maks7d/fcg4/README.md

This project aims to develop an ultra minimalist flight controller for betaflight firmware for FPV drones.
The components are : 
- STM32G473CEU6 (mcu)
- SPL006 (barometer)
- ICM-42688-P (gyro/accel)
No analog OSD and no BlackBox
