maks7d/fcg4/.step

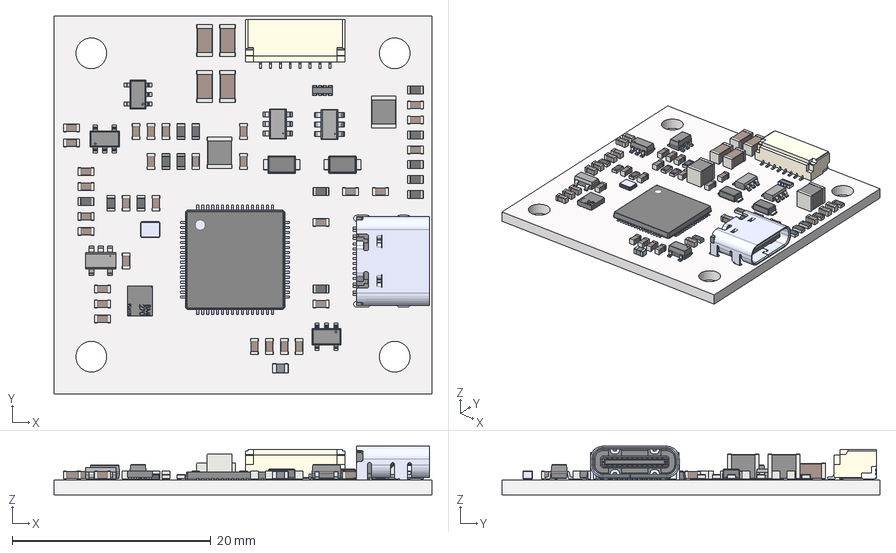
[picture p1: CAD file, 2026-05-31]
.step
38.0 x 38.0 x 4.91 mm
R_0603_1608Metric x 14
PinsArrayL x 3
PinsArrayR x 3
C_0603_1608Metric x 30
C_1206_3216Metric x 4
AP2112K-1_8TRG1_DIO
EXB-28V101JX
STM32G473RCT6
SM08B-SRSS-TB
MP2456GJ-Z x 2
L_1210_3225Metric x 2
BMI270
CPD x 2
Lead x 2
Lead_2 x 2
Outer plating_2 x 2
Outer plating x 2
BLM18RK601SN1D
USB4105xxx_USB4105GFA120
ECS-240-6-37B-7KM-TR
fcg4_PCB
