maks7d/fcg4/3D/BMI270.stp

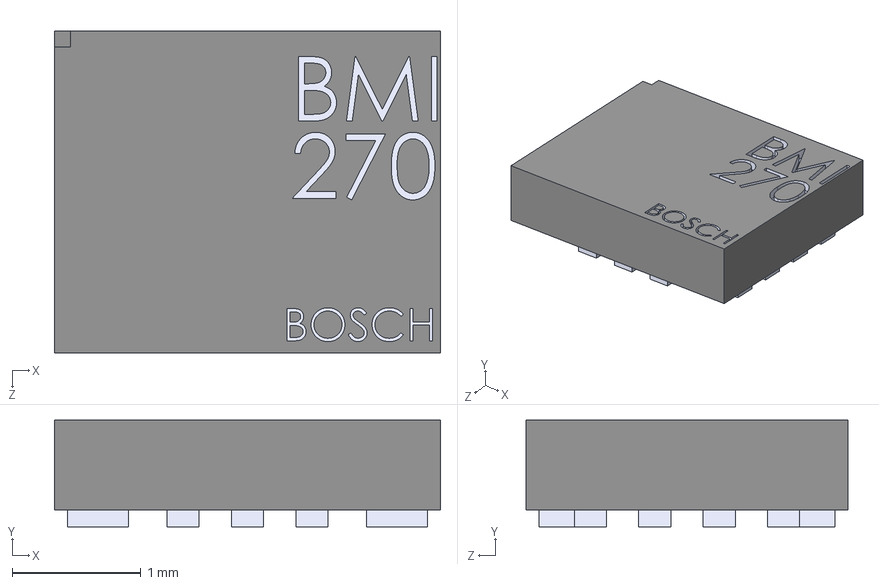
[picture p2: CAD file, 2026-04-12]
3D/BMI270.stp
3.00 x 0.83 x 2.50 mm
