maks7d/fcg4/3D/STM32G473RCT6.stp

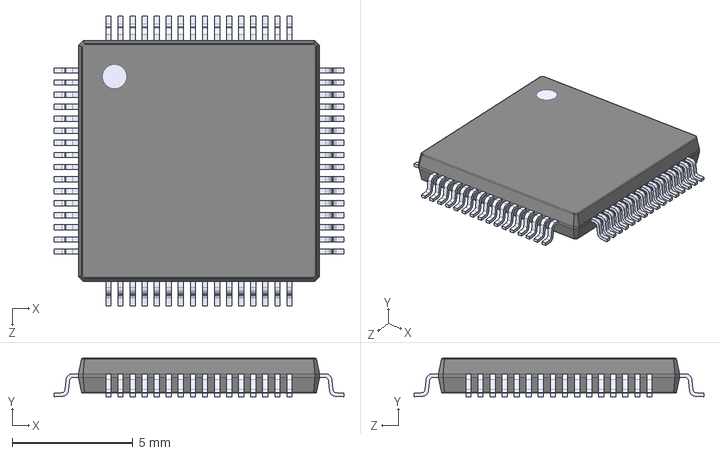
[picture p3: CAD file, 2026-03-20]
3D/STM32G473RCT6.stp
12.0 x 1.60 x 12.0 mm
