maks7d/fcg4/Stencil_jig_template.stl

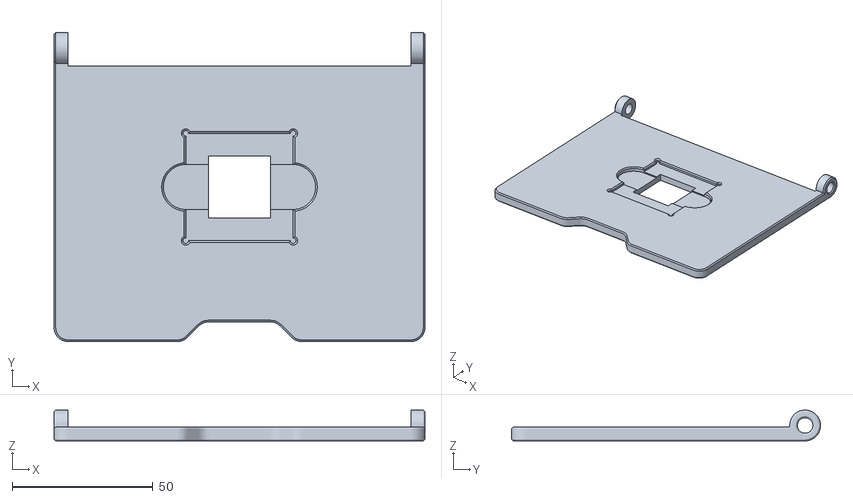
[picture p4: CAD file, 2026-05-31]
Stencil_jig_template.stl
132.0 x 110.0 x 11.0
