maks7d/fcg4/3D/STM32G473CET6.stp

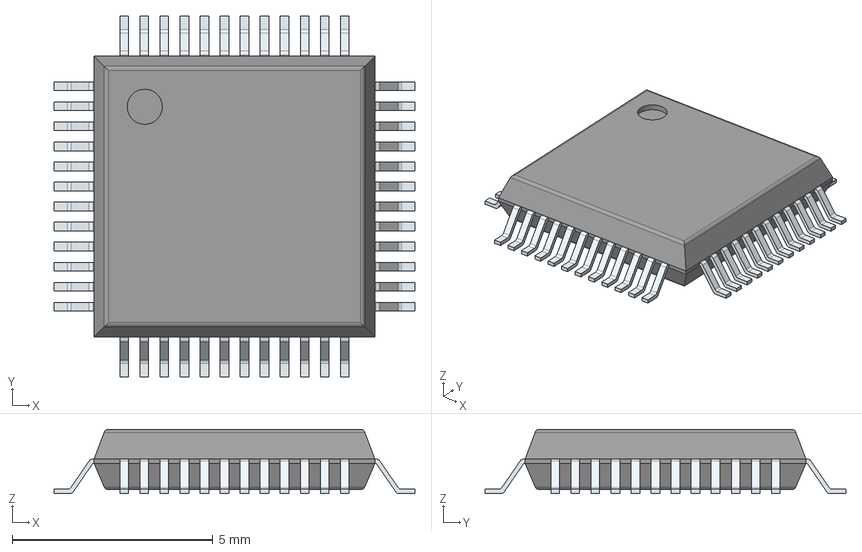
[picture p5: CAD file, 2026-03-20]
3D/STM32G473CET6.stp
9.00 x 9.00 x 1.60 mm
PinsArrayLR
PinsArrayTB
