maks7d/fcg4/3D/MP2456GJ-Z.stp

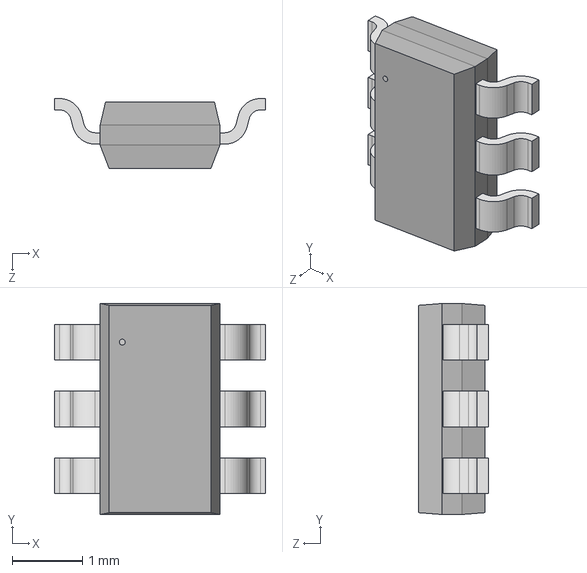
[picture p6: CAD file, 2026-02-27]
3D/MP2456GJ-Z.stp
3.00 x 3.00 x 0.993 mm
