maks7d/fcg4/3D/DFLS160-7.stp

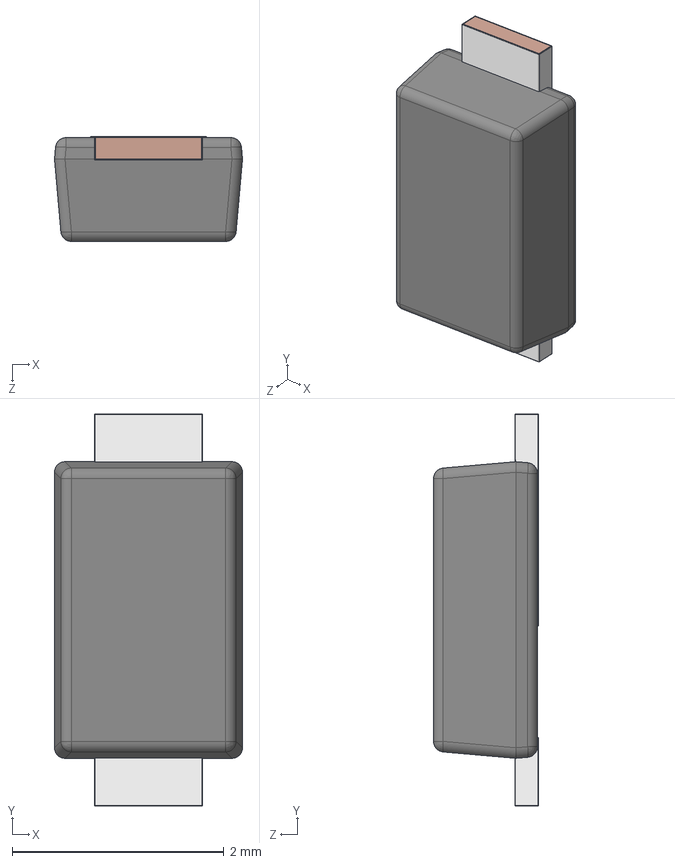
[picture p7: CAD file, 2026-02-27]
3D/DFLS160-7.stp
1.77 x 3.70 x 0.99 mm
CPD
Lead
Lead_2
Outer plating_2
Outer plating
