maks7d/fcg4/3D/STM32G473CEU6.stp

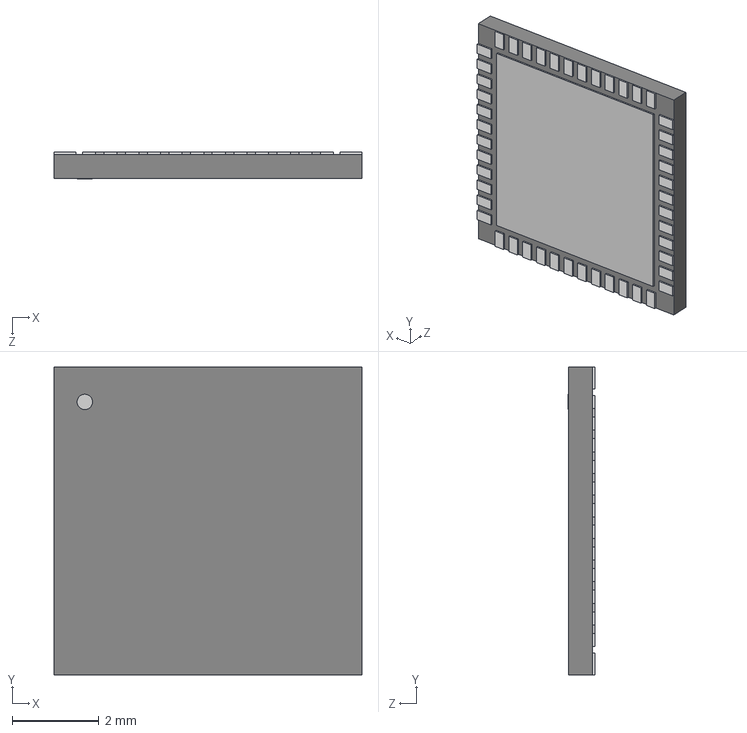
[picture p8: CAD file, 2026-02-18]
3D/STM32G473CEU6.stp
7.11 x 7.11 x 0.612 mm
