maks7d/fcg4/3D/AP2112K-3.3TRG1.stp

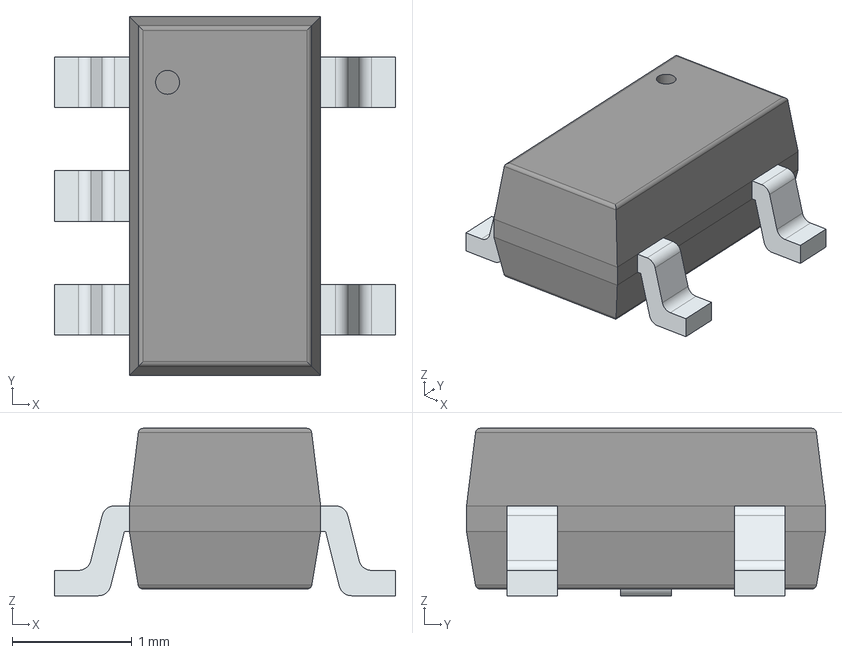
[picture p9: CAD file, 2026-02-18]
3D/AP2112K-3.3TRG1.stp
2.85 x 3.00 x 1.40 mm
PinsArrayL
PinsArrayR
