maks7d/fcg4/3D/EXB-28V101JX.STEP

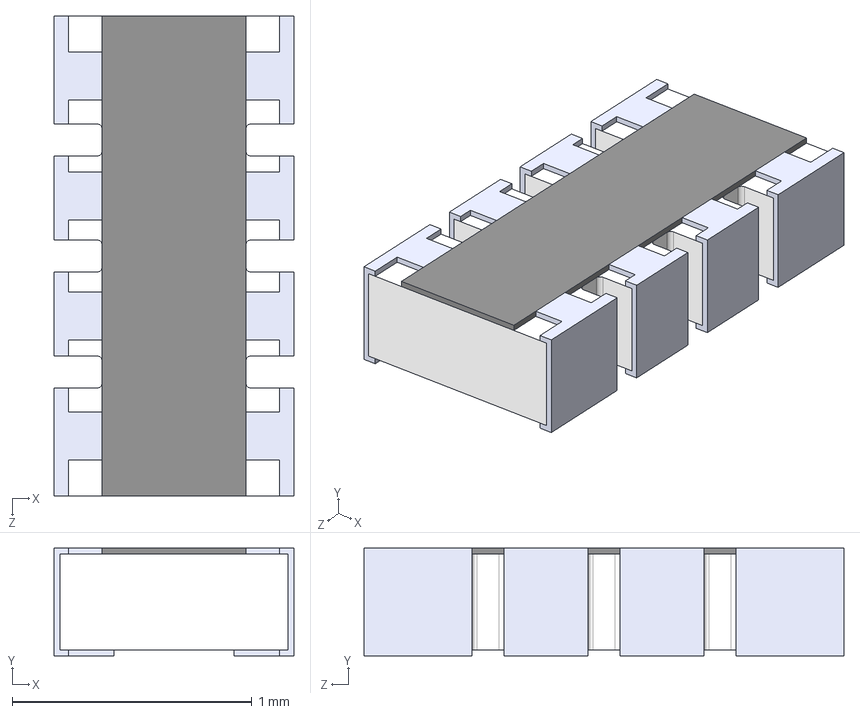
[picture p10: CAD file, 2026-02-18]
3D/EXB-28V101JX.STEP
1.00 x 0.45 x 2.00 mm
