maks7d/fcg4/3D/SM08B-SRSS-TB.step

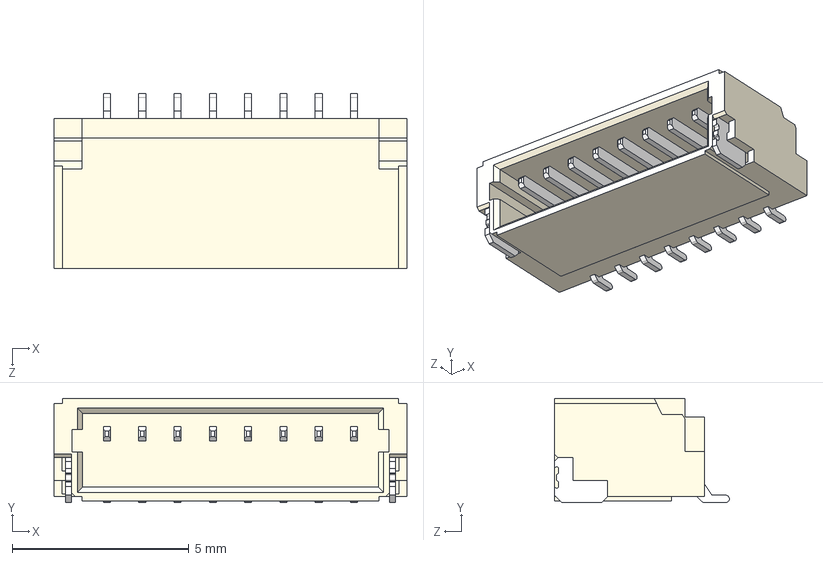
[picture p11: CAD file, 2026-02-15]
3D/SM08B-SRSS-TB.step
10.00 x 2.95 x 4.95 mm
