maks7d/fcg4/3D/ECS-240-6-37B-7KM-TR.step

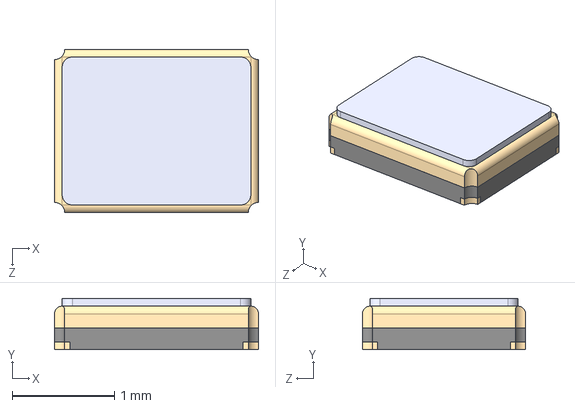
[picture p12: CAD file, 2026-02-15]
3D/ECS-240-6-37B-7KM-TR.step
2.00 x 0.5 x 1.60 mm
