maks7d/fcg4/3D/CX2016DB25000D0GPSC1.stp

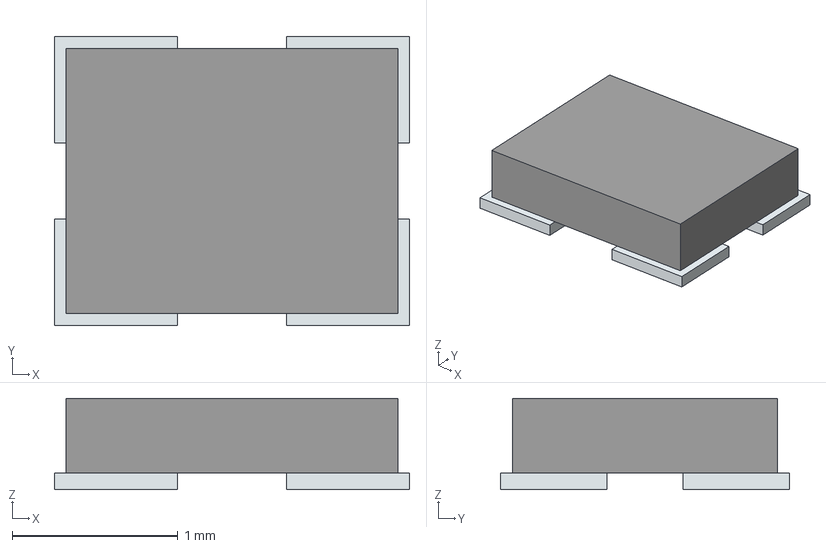
[picture p13: CAD file, 2026-02-14]
3D/CX2016DB25000D0GPSC1.stp
2.14 x 1.74 x 0.55 mm
Pins
