maks7d/fcg4/3D/BLM18RK601SN1D.step

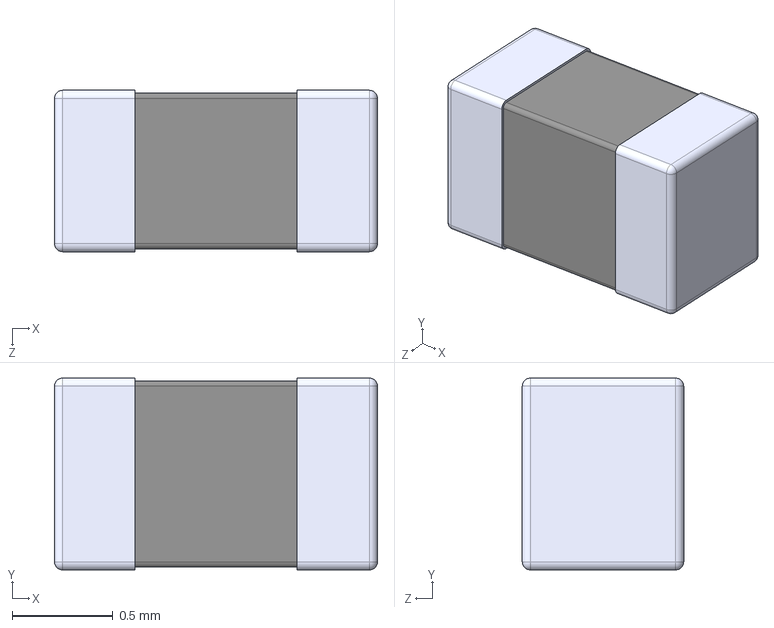
[picture p14: CAD file, 2026-02-14]
3D/BLM18RK601SN1D.step
1.60 x 0.95 x 0.8 mm
