maks7d/fcg4/3D/USB4105-GF-A-120.step

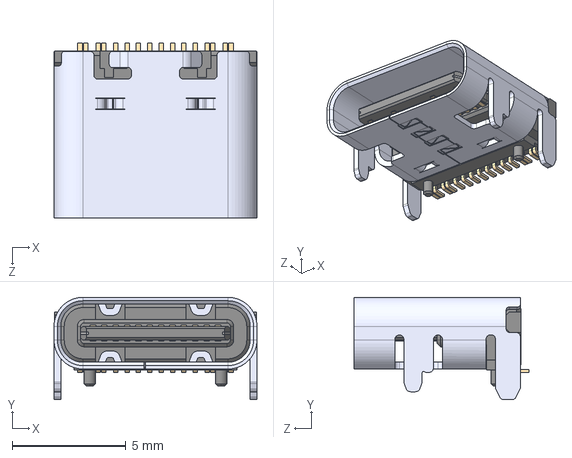
[picture p15: CAD file, 2026-02-13]
3D/USB4105-GF-A-120.step
8.94 x 4.51 x 7.71 mm
