maks7d/fcg4/3D/ABM3C-25.000MHZ-D4Y-T.STEP

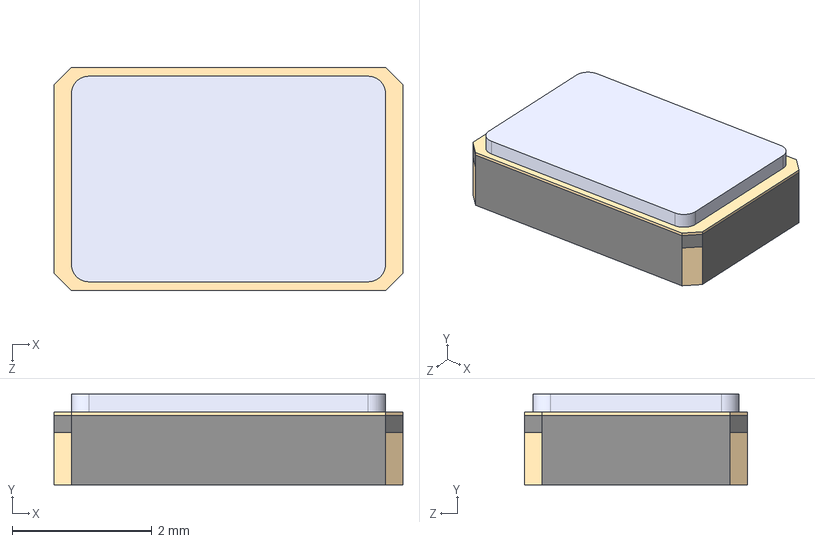
[picture p16: CAD file, 2026-02-13]
3D/ABM3C-25.000MHZ-D4Y-T.STEP
5.00 x 1.30 x 3.20 mm
