maks7d/fcg4/3D/SM04B-SRSS-TB.STEP

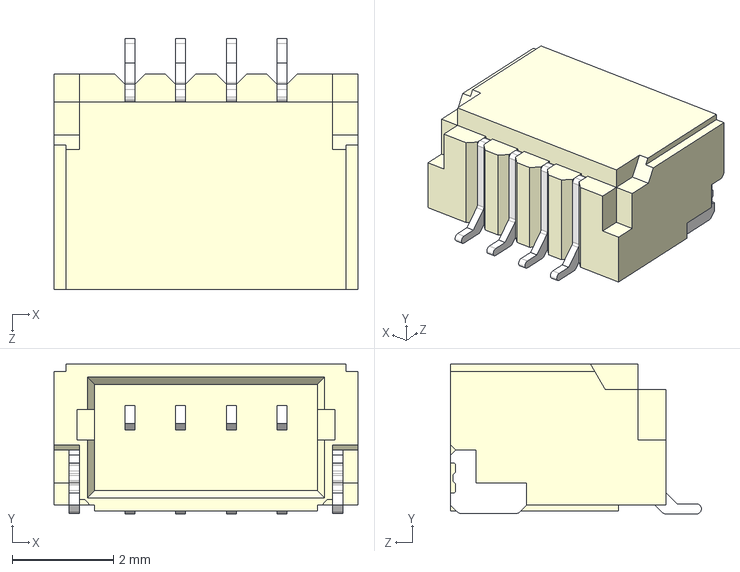
[picture p17: CAD file, 2026-02-12]
3D/SM04B-SRSS-TB.STEP
6.00 x 2.96 x 4.95 mm
