maks7d/fcg4/3D/1N5819HW-7-F.stp

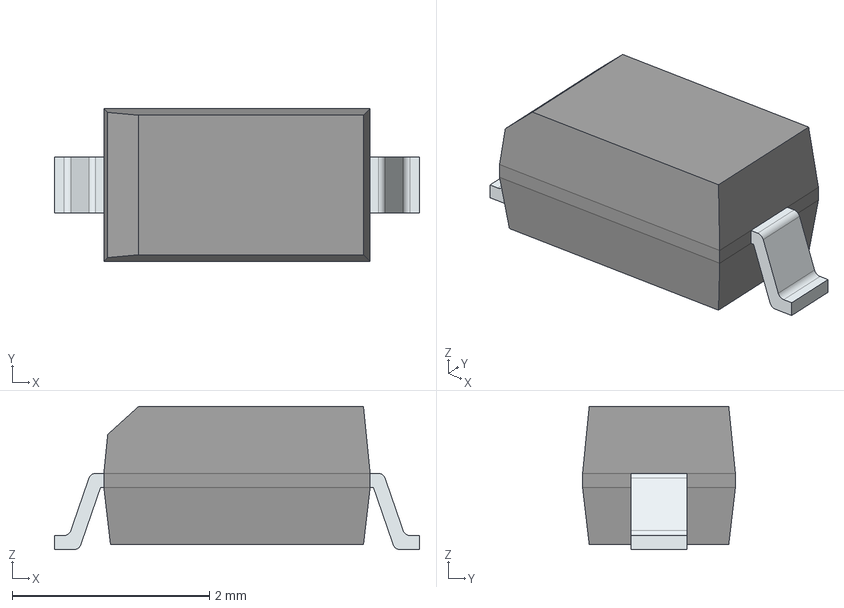
[picture p18: CAD file, 2026-02-12]
3D/1N5819HW-7-F.stp
3.70 x 1.55 x 1.45 mm
FilletPinL
FilletPinR
