maks7d/fcg4/3D/AP2112K-1_8TRG1_DIO.step

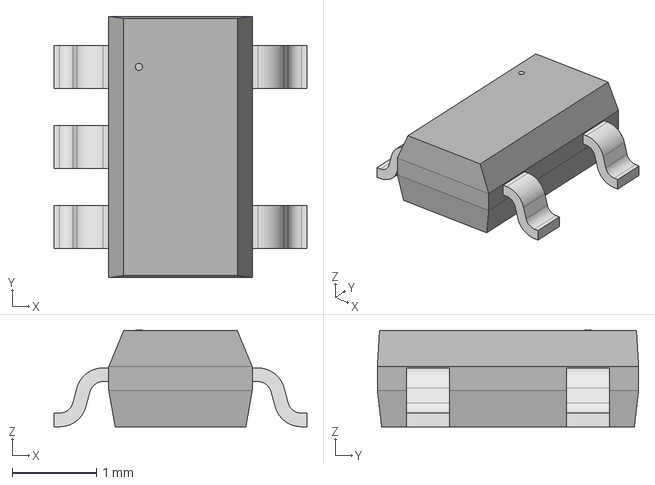
[picture p19: CAD file, 2026-02-12]
3D/AP2112K-1_8TRG1_DIO.step
3.00 x 3.10 x 1.15 mm
