maks7d/fcg4/3D/Goertek SPL06-001.stp

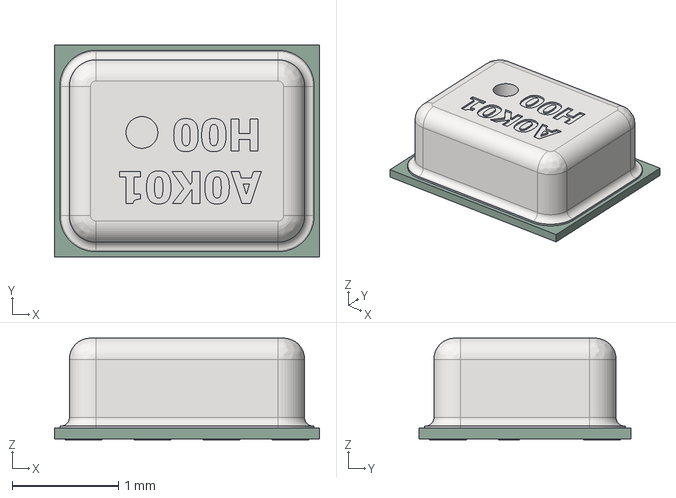
[picture p20: CAD file, 2026-02-12]
3D/Goertek SPL06-001.stp
2.50 x 2.00 x 0.96 mm
