maks7d/fcg4/3D/MP9943AGQ-Z.stp

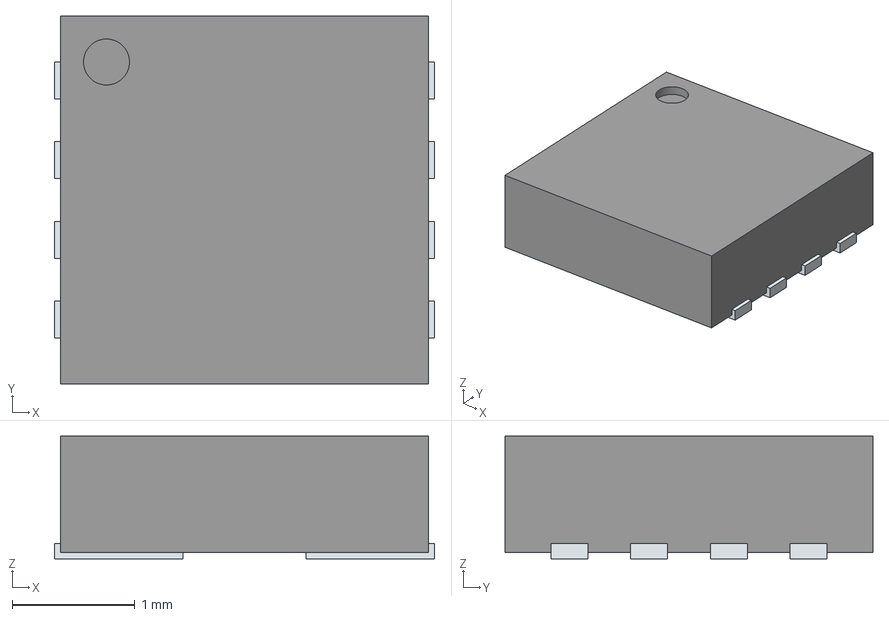
[picture p21: CAD file, 2026-02-12]
3D/MP9943AGQ-Z.stp
3.10 x 3.00 x 1.00 mm
PinsArrayLR
