maks7d/fcg4/3D/ICM-42688-P.step

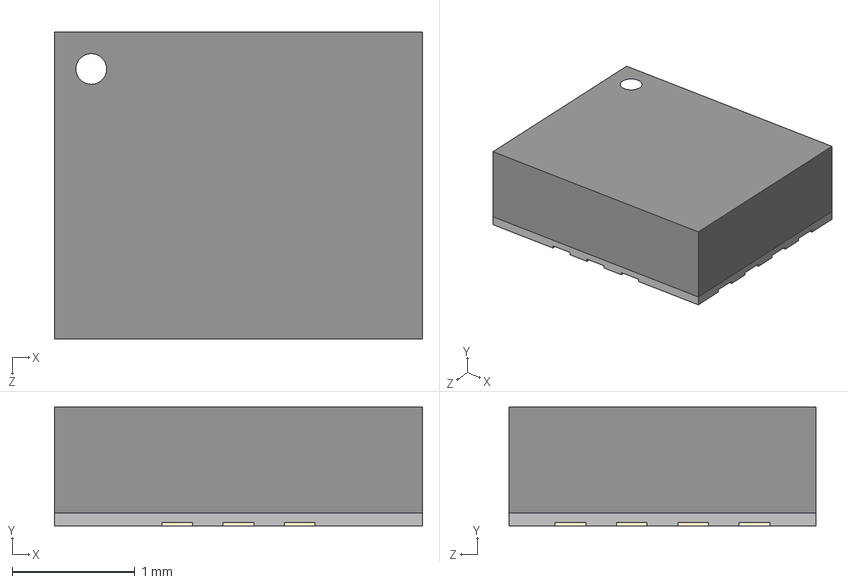
[picture p22: CAD file, 2026-02-11]
3D/ICM-42688-P.step
3.00 x 0.97 x 2.50 mm
