maks7d/fcg4/(list of files, cad)

Other CAD files:
3D/2171750001.step
3D/MAX40200ANS_T.step
3D/MAX40203AUK+T.stp
