maks7d/fcg4/fcg4.kicad_pcb

## KiCad design fcg4.kicad_pcb (2026-05-31)

Schematic: fcg4.kicad_sch

Parts:
H1: MountingHole; MountingHoles_30.5x30.5mm_Standard

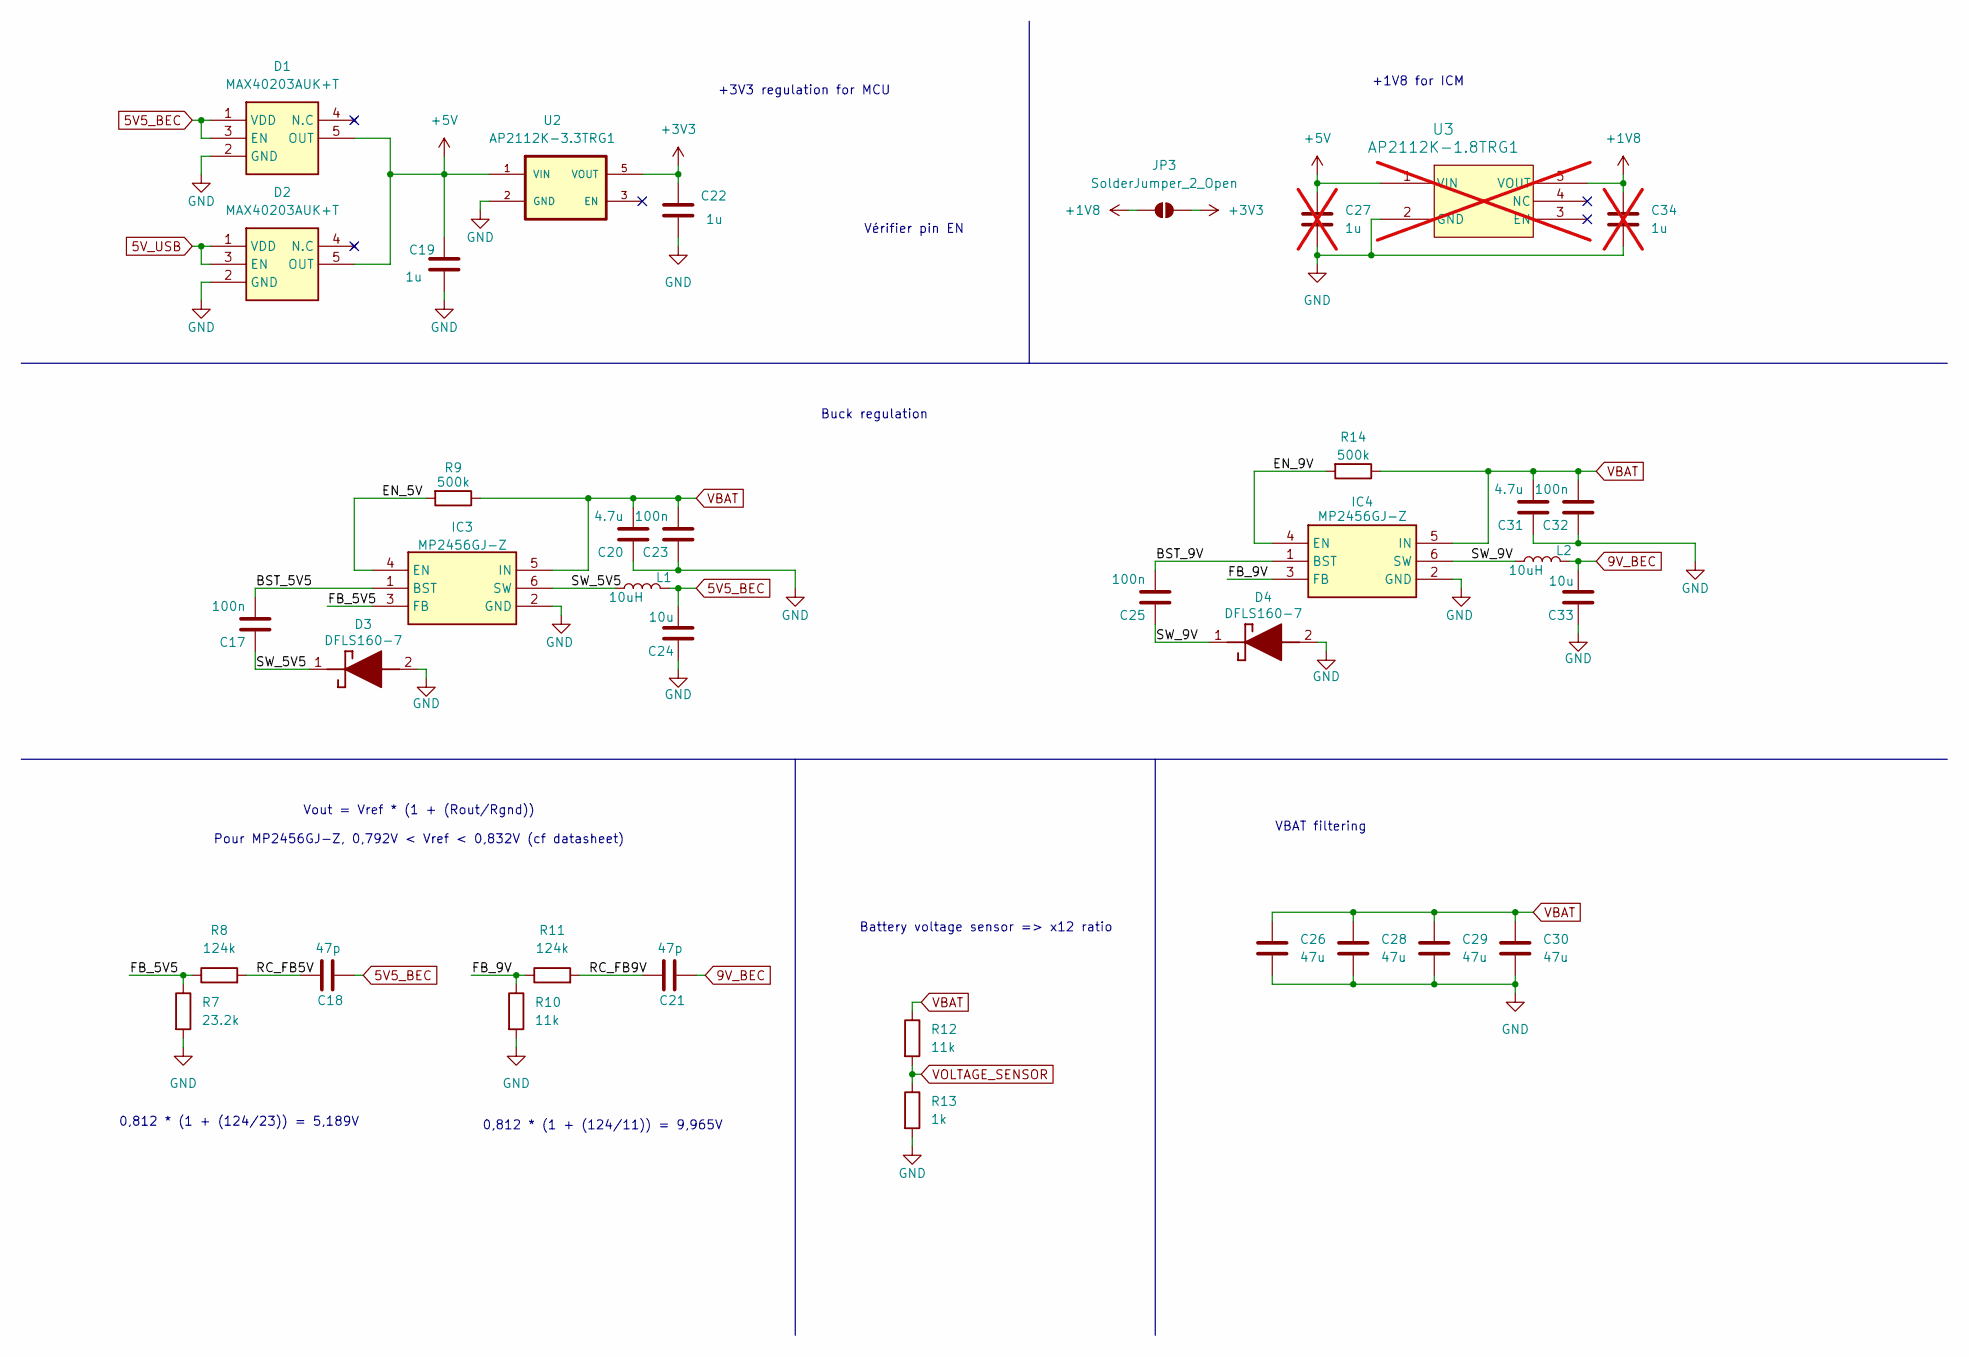
[picture p23: schematic power.kicad_sch]

Parts:
C17, C23, C25, C32: 100n; C_0603_1608Metric; Manufacturer_Part_Number CL10B104KB8NNNC; LCSC Part Name C1591
C18, C21: 47p; C_0603_1608Metric; Manufacturer_Part_Number CC0603JRNPO9BN470; LCSC Part Name C105622
C19, C22: 1u; C_0603_1608Metric; Manufacturer_Part_Number CL10B105KB8NQNC; LCSC Part Name C5199872
C20, C31: 4.7u; C_0603_1608Metric; Manufacturer_Part_Number CL10A475KL8NRNC; LCSC Part Name C307467
C24, C33: 10u; C_0603_1608Metric; Manufacturer_Part_Number GRM188R6YA106MA73D; LCSC Part Name C194427
C26, C28, C29, C30: 47u; C_1206_3216Metric; Manufacturer_Part_Number C3216X5R1E476MTJ00E; LCSC Part Name C76659
C27, C34: 1u; C_0603_1608Metric; Manufacturer_Part_Number CL10B105KB8NQNC; LCSC Part Name C5199872; not fitted
D1, D2: MAX40203AUK+T; SOT95P280X145-5M; Mouser Part Number 700-MAX40203AUK+T
D3, D4: DFLS160-7; DFLS1607; Mouser Part Number 621-DFLS160-F
IC3, IC4: MP2456GJ-Z; SOP95P280X100-6M; Mouser Part Number 946-MP2456GJ-Z
JP3: SolderJumper_2_Open; SolderJumper-2_P1.3mm_Open_TrianglePad1.0x1.5mm
L1, L2: 10uH; L_1210_3225Metric; Manufacturer_Part_Number XRTC322512S100MBCA; LCSC Part Name C39846661
R7: 23.2k; R_0603_1608Metric; Manufacturer_Part_Number RT0603BRE0723K2L; LCSC Part Name C861768
R8, R11: 124k; R_0603_1608Metric; Manufacturer_Part_Number 0603WAF1243T5E; LCSC Part Name C22788
R9, R14: 500k; R_0603_1608Metric; Manufacturer_Part_Number 0603WAF4993T5E; LCSC Part Name C26751
R10, R12: 11k; R_0603_1608Metric; Manufacturer_Part_Number 0603WAF1102T5E; LCSC Part Name C25950
R13: 1k; R_0603_1608Metric; Manufacturer_Part_Number RC0603FR-071KL; LCSC Part Name C22548
U2: AP2112K-3.3TRG1; SOT95P285X140-5N; PARTREV 2-2; DigiKey_Part_Number AP2112K-3.3TRG1DICT-ND
U3: AP2112K-1.8TRG1; AP2112K-1.8TRG1_DIO; Manufacturer_Part_Number AP2112K-1.8TRG1; Mouser Part Number 621-AP2112K-1.8TRG1; not fitted

Connections:
5V5_BEC: C18.1, C24.2, D1.1 (VDD), D1.3 (EN), L1.2; also elsewhere on the board
5V_USB: D2.1 (VDD), D2.3 (EN); also elsewhere on the board
9V_BEC: C21.1, C33.2, L2.2; also elsewhere on the board
+1V8: C34.1, JP3.1 (A), U3.5 (VOUT); also elsewhere on the board
+3V3: C22.1, JP3.2 (B), U2.5 (VOUT); also elsewhere on the board
+5V: C19.1, C27.1, D1.5 (OUT), D2.5 (OUT), U2.1 (VIN), U3.1 (VIN); also elsewhere on the board
/Power/BST_5V5: C17.2, IC3.1 (BST)
/Power/BST_9V: C25.2, IC4.1 (BST)
/Power/EN_5V: IC3.4 (EN), R9.2
/Power/EN_9V: IC4.4 (EN), R14.2
/Power/FB_5V5: IC3.3 (FB), R7.1, R8.1
/Power/FB_9V: IC4.3 (FB), R10.1, R11.1
/Power/RC_FB5V: C18.2, R8.2
/Power/RC_FB9V: C21.2, R11.2
/Power/SW_5V5: C17.1, D3.1 (K), IC3.6 (SW), L1.1
/Power/SW_9V: C25.1, D4.1 (K), IC4.6 (SW), L2.1
GND: C19.2, C20.1, C22.2, C23.1, C24.1, C26.2, C27.2, C28.2, C29.2, C30.2, C31.1, C32.1, C33.1, C34.2, D1.2 (GND), D2.2 (GND), D3.2 (A), D4.2 (A), IC3.2 (GND), IC4.2 (GND), R7.2, R10.2, R13.2, U2.2 (GND), U3.2 (GND); also elsewhere on the board
VBAT: C20.2, C23.2, C26.1, C28.1, C29.1, C30.1, C31.2, C32.2, IC3.5 (IN), IC4.5 (IN), R9.1, R12.1, R14.1; also elsewhere on the board
VOLTAGE_SENSOR: R12.2, R13.1; also elsewhere on the board

Notes on the sheet:
+3V3 regulation for MCU
Vérifier pin EN
Vout = Vref * (1 + (Rout/Rgnd)) Pour MP2456GJ-Z, 0,792V < Vref < 0,832V (cf datasheet)
0,812 * (1 + (124/23)) = 5,189V
Battery voltage sensor => x12 ratio
+1V8 for ICM
0,812 * (1 + (124/11)) = 9,965V
VBAT filtering
Buck regulation

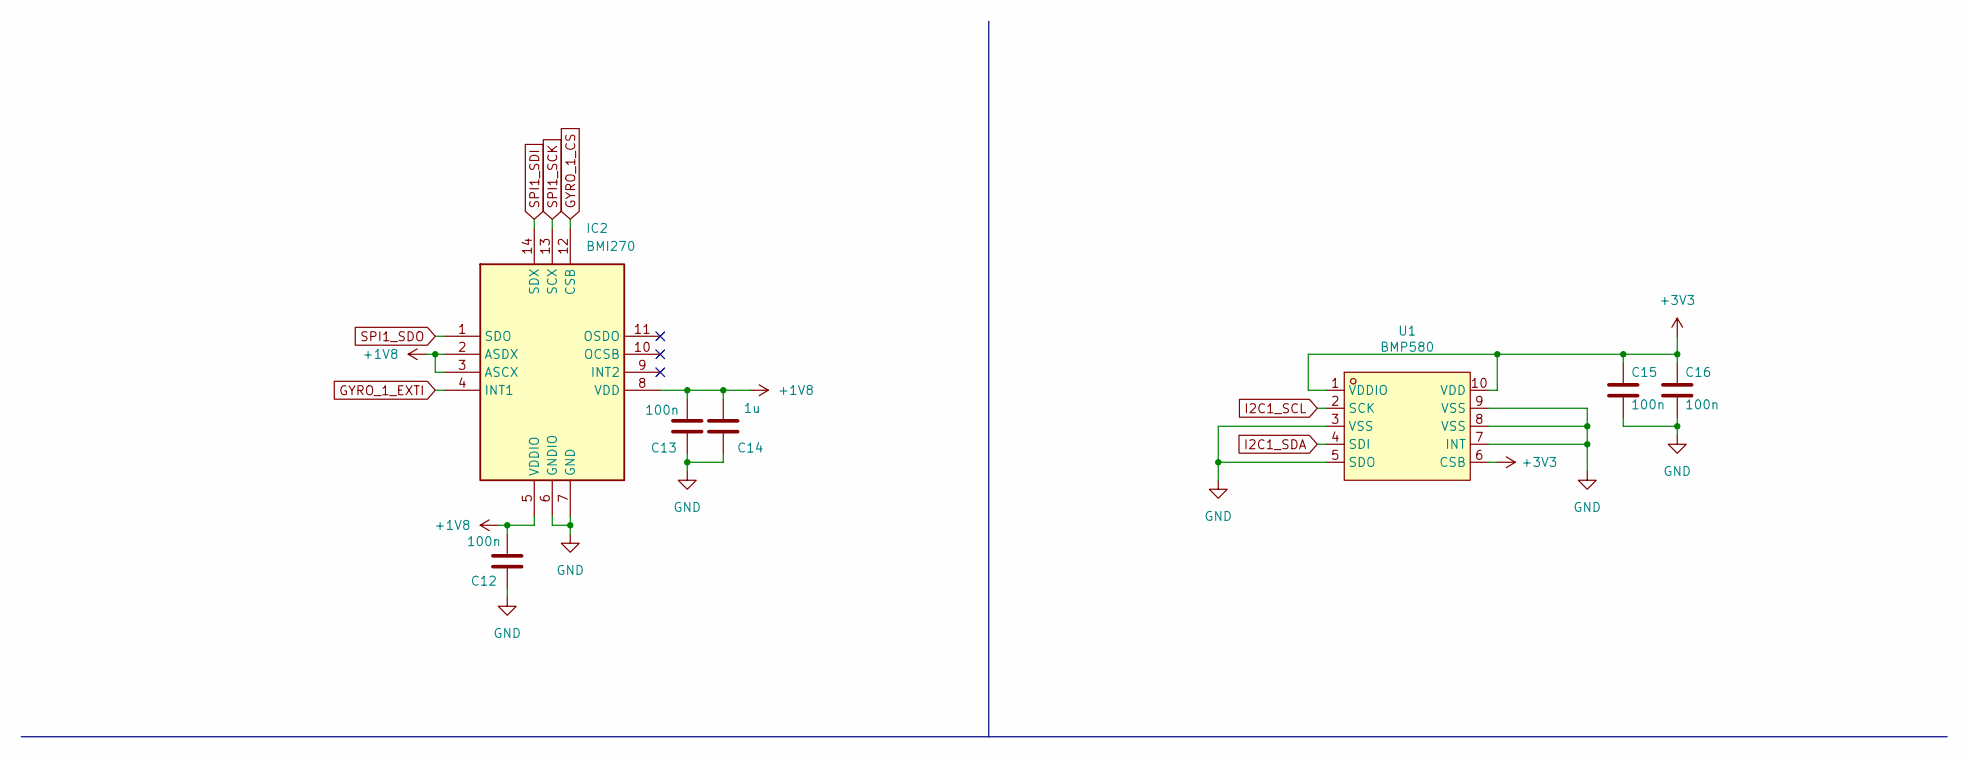
[picture p24: schematic sensor.kicad_sch]

Parts:
C12, C13, C15, C16: 100n; C_0603_1608Metric; Manufacturer_Part_Number CL10B104KB8NNNC; LCSC Part Name C1591
C14: 1u; C_0603_1608Metric; Manufacturer_Part_Number CL10B104KB8NNNC; LCSC Part Name C5199872
IC2: BMI270; Mouser Part Number 262-BMI270
U1: BMP580; LGA-10_L2.0-W2.0-P0.50-TL_BMP580; Manufacturer Part BMP580; LCSC Part Name C22391138

Connections:
+1V8: C12.2, C13.2, C14.2, IC2.2 (ASDX), IC2.3 (ASCX), IC2.5 (VDDIO), IC2.8 (VDD); also elsewhere on the board
+3V3: C15.2, C16.2, U1.1 (VDDIO), U1.6 (CSB), U1.10 (VDD); also elsewhere on the board
GND: C12.1, C13.1, C14.1, C15.1, C16.1, IC2.6 (GNDIO), IC2.7 (GND), U1.3 (VSS), U1.5 (SDO), U1.7 (INT), U1.8 (VSS), U1.9 (VSS); also elsewhere on the board
GYRO_1_CS: IC2.12 (CSB); also elsewhere on the board
GYRO_1_EXTI: IC2.4 (INT1); also elsewhere on the board
I2C1_SCL: U1.2 (SCK); also elsewhere on the board
I2C1_SDA: U1.4 (SDI); also elsewhere on the board
SPI1_SCK: IC2.13 (SCX); also elsewhere on the board
SPI1_SDI: IC2.14 (SDX); also elsewhere on the board
SPI1_SDO: IC2.1 (SDO); also elsewhere on the board

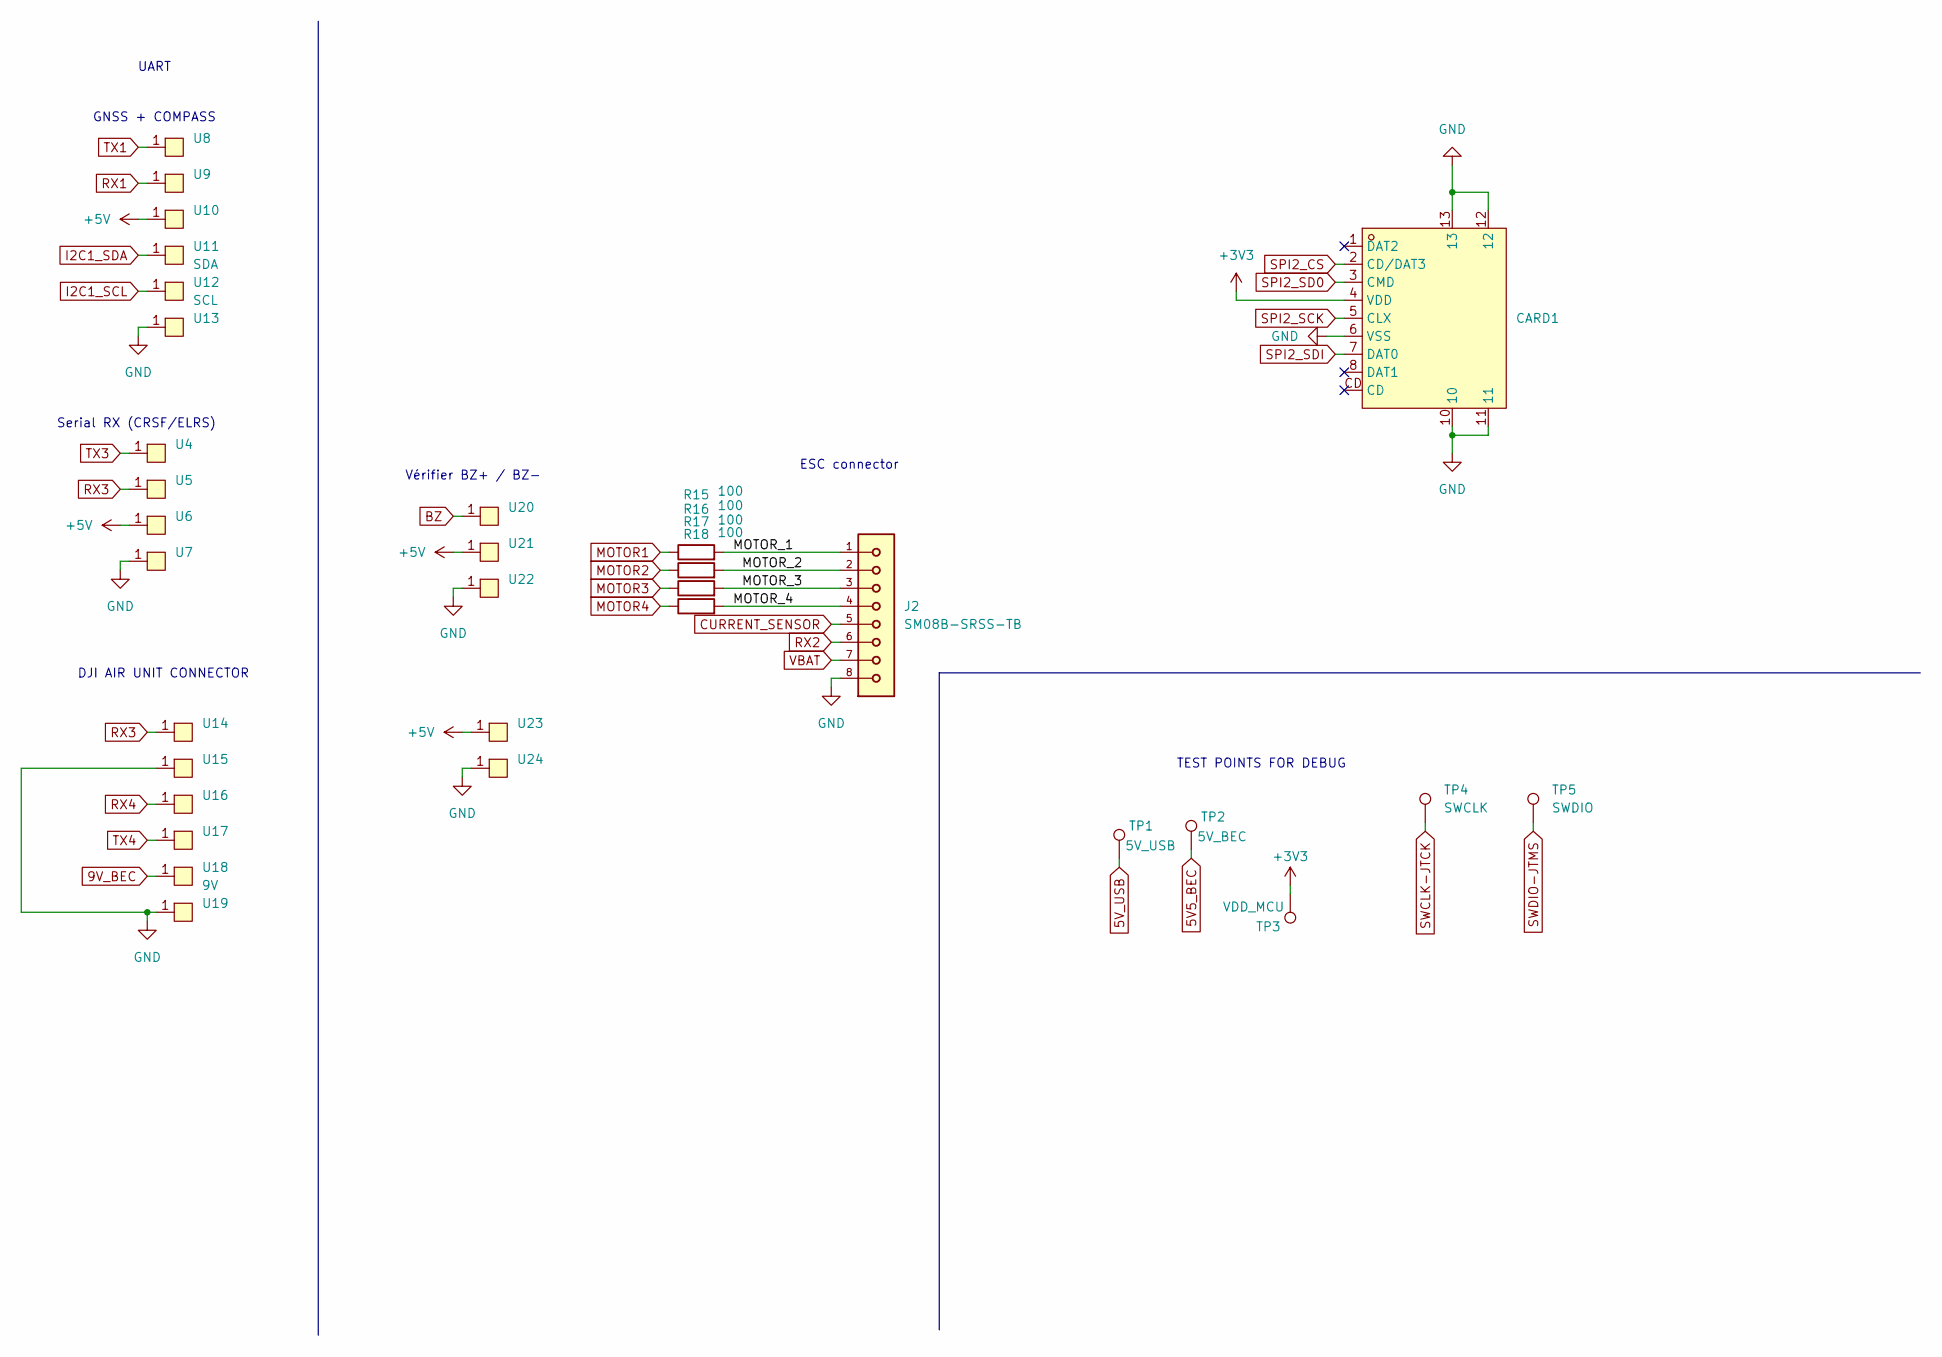
[picture p25: schematic connectors.kicad_sch]

Parts:
CARD1: TF-SMD_TF-PUSH; Manufacturer Part TF PUSH; LCSC Part Name 9P，自弹式TF卡座
J2: SM08B-SRSS-TB; JST_SM08B-SRSS-TB; Manufacturer_Part_Number SM08B-SRSS-TB(LF)(SN); DigiKey_Part_Number 455-1808-1-ND
R15, R16, R17, R18: 100; R_0603_1608Metric; Manufacturer_Part_Number FRC0603F5101TS; LCSC Part Name C2907044
TP1: 5V_USB; TestPoint_Pad_D1.0mm
TP2: 5V_BEC; TestPoint_Pad_D1.0mm
TP3: VDD_MCU; TestPoint_Pad_D1.0mm
TP4: SWCLK; TestPoint_Pad_D1.0mm
TP5: SWDIO; TestPoint_Pad_D1.0mm
U4, U5, U6, U7, U8, U9, U10, U13, U14, U15, U16, U17, U19, U20, U21, U22, U23, U24: soldering_pad
U11: SDA; soldering_pad
U12: SCL; soldering_pad
U18: 9V; soldering_pad

Connections:
5V5_BEC: TP2.1 (1_1); also elsewhere on the board
5V_USB: TP1.1 (1_1); also elsewhere on the board
9V_BEC: U18.1; also elsewhere on the board
+3V3: CARD1.4 (VDD), TP3.1 (1_1); also elsewhere on the board
+5V: U6.1, U10.1, U21.1, U23.1; also elsewhere on the board
/Connectors/MOTOR_1: J2.1, R15.2
/Connectors/MOTOR_2: J2.2, R16.2
/Connectors/MOTOR_3: J2.3, R17.2
/Connectors/MOTOR_4: J2.4, R18.2
BZ: U20.1; also elsewhere on the board
CURRENT_SENSOR: J2.5; also elsewhere on the board
GND: CARD1.6 (VSS), CARD1.10, CARD1.11, CARD1.12, CARD1.13, J2.8, U7.1, U13.1, U15.1, U19.1, U22.1, U24.1; also elsewhere on the board
I2C1_SCL: U12.1; also elsewhere on the board
I2C1_SDA: U11.1; also elsewhere on the board
MOTOR1: R15.1; also elsewhere on the board
MOTOR2: R16.1; also elsewhere on the board
MOTOR3: R17.1; also elsewhere on the board
MOTOR4: R18.1; also elsewhere on the board
RX1: U9.1; also elsewhere on the board
RX2: J2.6; also elsewhere on the board
RX3: U5.1, U14.1; also elsewhere on the board
RX4: U16.1; also elsewhere on the board
SPI2_CS: CARD1.2 (CD/DAT3); also elsewhere on the board
SPI2_SCK: CARD1.5 (CLX); also elsewhere on the board
SPI2_SD0: CARD1.3 (CMD); also elsewhere on the board
SPI2_SDI: CARD1.7 (DAT0); also elsewhere on the board
SWCLK-JTCK: TP4.1 (1_1); also elsewhere on the board
SWDIO-JTMS: TP5.1 (1_1); also elsewhere on the board
TX1: U8.1; also elsewhere on the board
TX3: U4.1; also elsewhere on the board
TX4: U17.1; also elsewhere on the board
VBAT: J2.7; also elsewhere on the board

Notes on the sheet:
TEST POINTS FOR DEBUG
UART
GNSS + COMPASS
DJI AIR UNIT CONNECTOR
Vérifier BZ+ / BZ-
Serial RX (CRSF/ELRS)
ESC connector

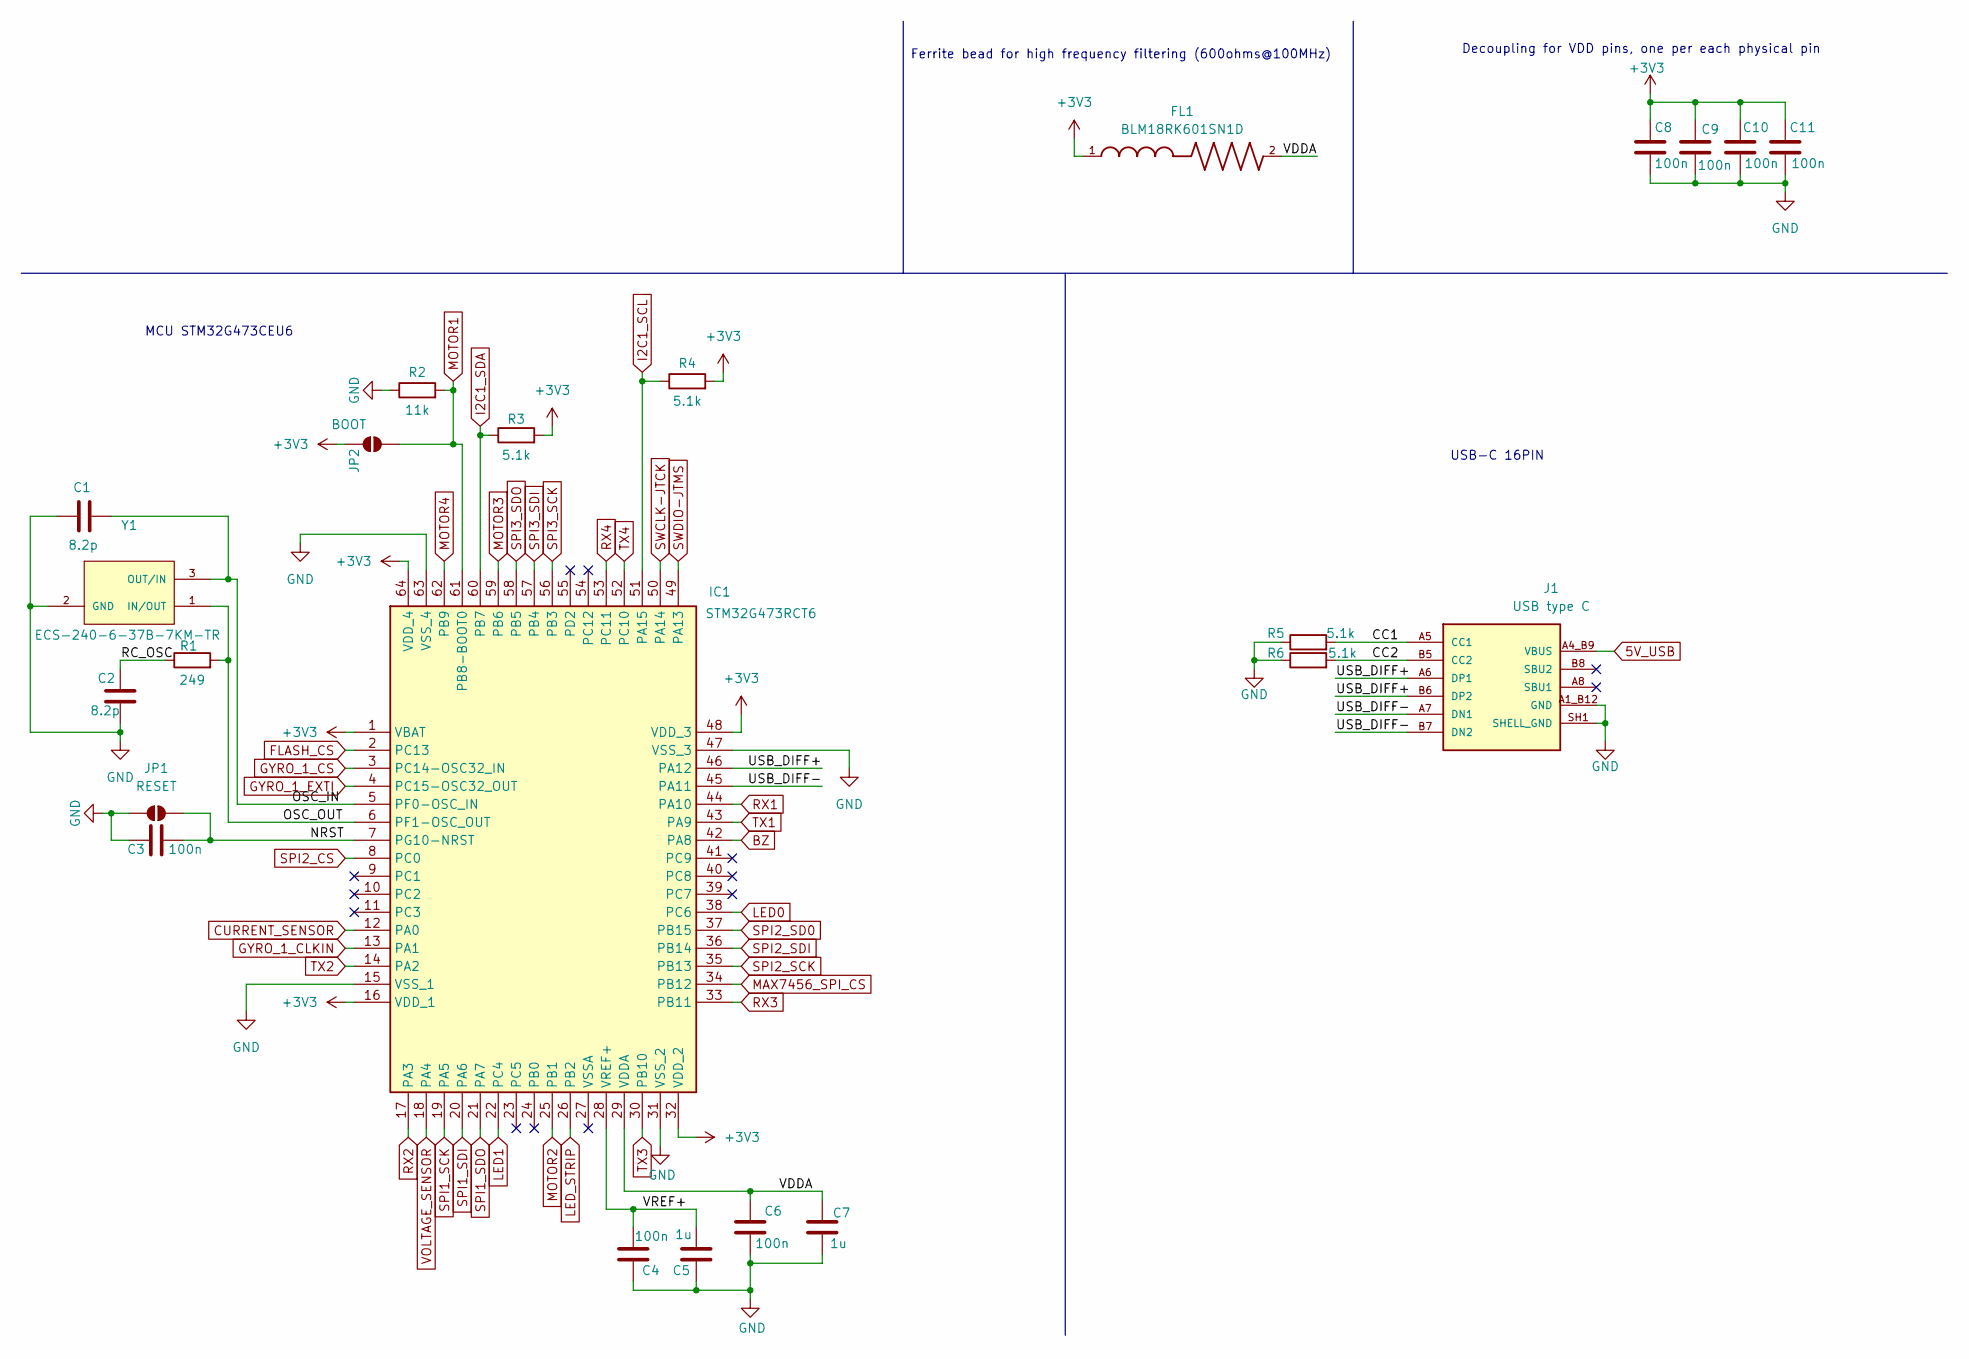
[picture p26: schematic mcu.kicad_sch]

Parts:
C1, C2: 8.2p; C_0603_1608Metric; Manufacturer_Part_Number CC0603CRNPO9BN8R2; LCSC Part Name C277519
C3, C4, C6, C8, C9, C10, C11: 100n; C_0603_1608Metric; Manufacturer_Part_Number CL10B104KB8NNNC; LCSC Part Name C1591
C5, C7: 1u; C_0603_1608Metric; Manufacturer_Part_Number CL10B105KB8NQNC; LCSC Part Name C5199872
FL1: BLM18RK601SN1D; BEADC1608X95N; Manufacturer_Part_Number BLM18RK601SN1D; DigiKey_Part_Number 490-5227-1-ND
IC1: STM32G473RCT6; QFP50P1200X1200X160-64M; Mouser Part Number 511-STM32G473RCT6
J1: USB type C; GCT_USB4105-GF-A-120; PARTREV B3; DigiKey_Part_Number 2073-USB4105-GF-A-120CT-ND
JP1: RESET; SolderJumper-2_P1.3mm_Open_RoundedPad1.0x1.5mm
JP2: BOOT; SolderJumper-2_P1.3mm_Open_RoundedPad1.0x1.5mm
R1: 249; R_0603_1608Metric; Manufacturer_Part_Number FRC0603F2490TS; LCSC Part Name C2933176
R2: 11k; R_0603_1608Metric; Manufacturer_Part_Number 0603WAF1102T5E; LCSC Part Name C25950
R3, R4, R5, R6: 5.1k; R_0603_1608Metric; Manufacturer_Part_Number FRC0603F5101TS; LCSC Part Name C2907044
Y1: ECS-240-6-37B-7KM-TR; XTAL_ECS-240-6-37B-7KM-TR; Manufacturer_Part_Number ECS-240-6-37B-7KM-TR; DigiKey_Part_Number 50-ECS-240-6-37B-7KM-CT-ND

Connections:
5V_USB: J1.A4_B9 (VBUS); also elsewhere on the board
+3V3: C8.1, C9.1, C10.1, C11.1, FL1.1, IC1.1 (VBAT), IC1.16 (VDD_1), IC1.32 (VDD_2), IC1.48 (VDD_3), IC1.64 (VDD_4), JP2.1 (A), R3.2, R4.2; also elsewhere on the board
/MCU/CC1: J1.A5 (CC1), R5.2
/MCU/CC2: J1.B5 (CC2), R6.2
/MCU/NRST: C3.2, IC1.7 (PG10-NRST), JP1.2 (B)
/MCU/OSC_IN: C1.2, IC1.5 (PF0-OSC_IN), Y1.3 (OUT/IN)
/MCU/OSC_OUT: IC1.6 (PF1-OSC_OUT), R1.2, Y1.1 (IN/OUT)
/MCU/RC_OSC: C2.1, R1.1
/MCU/USB_DIFF+: IC1.46 (PA12), J1.A6 (DP1), J1.B6 (DP2)
/MCU/USB_DIFF-: IC1.45 (PA11), J1.A7 (DN1), J1.B7 (DN2)
/MCU/VDDA: C6.2, C7.2, FL1.2, IC1.29 (VDDA)
/MCU/VREF+: C4.2, C5.2, IC1.28 (VREF+)
BZ: IC1.42 (PA8); also elsewhere on the board
CURRENT_SENSOR: IC1.12 (PA0); also elsewhere on the board
FLASH_CS: IC1.2 (PC13)
GND: C1.1, C2.2, C3.1, C4.1, C5.1, C6.1, C7.1, C8.2, C9.2, C10.2, C11.2, IC1.15 (VSS_1), IC1.31 (VSS_2), IC1.47 (VSS_3), IC1.63 (VSS_4), J1.A1_B12 (GND), J1.SH1 (SHELL_GND), JP1.1 (A), R2.1, R5.1, R6.1, Y1.2 (GND); also elsewhere on the board
GYRO_1_CLKIN: IC1.13 (PA1)
GYRO_1_CS: IC1.3 (PC14-OSC32_IN); also elsewhere on the board
GYRO_1_EXTI: IC1.4 (PC15-OSC32_OUT); also elsewhere on the board
I2C1_SCL: IC1.51 (PA15), R4.1; also elsewhere on the board
I2C1_SDA: IC1.60 (PB7), R3.1; also elsewhere on the board
LED0: IC1.38 (PC6)
LED1: IC1.22 (PC4)
LED_STRIP: IC1.26 (PB2)
MAX7456_SPI_CS: IC1.34 (PB12)
MOTOR1: IC1.61 (PB8-BOOT0), JP2.2 (B), R2.2; also elsewhere on the board
MOTOR2: IC1.25 (PB1); also elsewhere on the board
MOTOR3: IC1.59 (PB6); also elsewhere on the board
MOTOR4: IC1.62 (PB9); also elsewhere on the board
RX1: IC1.44 (PA10); also elsewhere on the board
RX2: IC1.17 (PA3); also elsewhere on the board
RX3: IC1.33 (PB11); also elsewhere on the board
RX4: IC1.53 (PC11); also elsewhere on the board
SPI1_SCK: IC1.19 (PA5); also elsewhere on the board
SPI1_SDI: IC1.20 (PA6); also elsewhere on the board
SPI1_SDO: IC1.21 (PA7); also elsewhere on the board
SPI2_CS: IC1.8 (PC0); also elsewhere on the board
SPI2_SCK: IC1.35 (PB13); also elsewhere on the board
SPI2_SD0: IC1.37 (PB15); also elsewhere on the board
SPI2_SDI: IC1.36 (PB14); also elsewhere on the board
SPI3_SCK: IC1.56 (PB3)
SPI3_SDI: IC1.57 (PB4)
SPI3_SDO: IC1.58 (PB5)
SWCLK-JTCK: IC1.50 (PA14); also elsewhere on the board
SWDIO-JTMS: IC1.49 (PA13); also elsewhere on the board
TX1: IC1.43 (PA9); also elsewhere on the board
TX2: IC1.14 (PA2)
TX3: IC1.30 (PB10); also elsewhere on the board
TX4: IC1.52 (PC10); also elsewhere on the board
VOLTAGE_SENSOR: IC1.18 (PA4); also elsewhere on the board

Notes on the sheet:
USB-C 16PIN
Ferrite bead for high frequency filtering (600ohms@100MHz)
Decoupling for VDD pins, one per each physical pin
MCU STM32G473CEU6

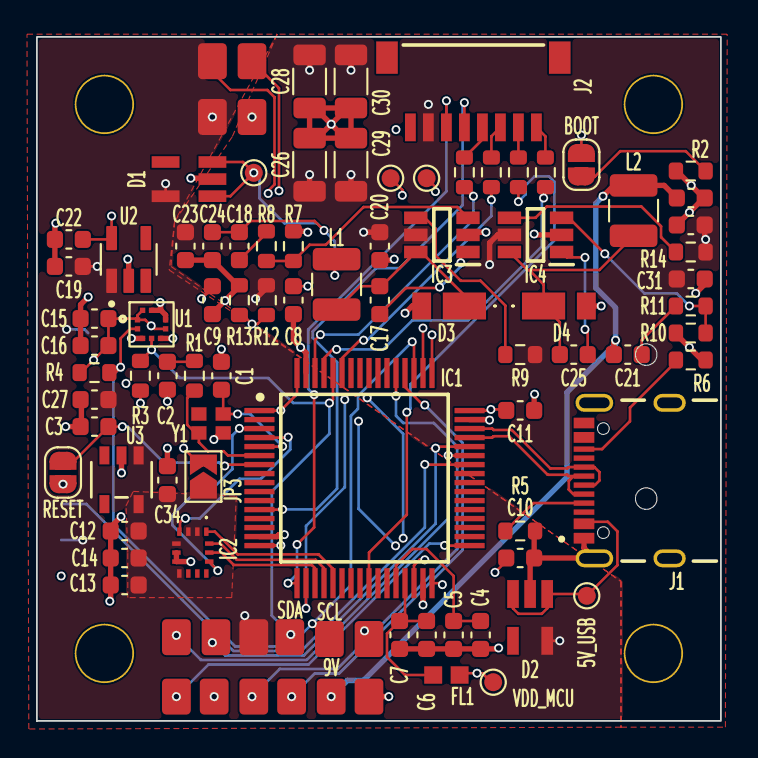
[picture p27: board fcg4.kicad_pcb from above]

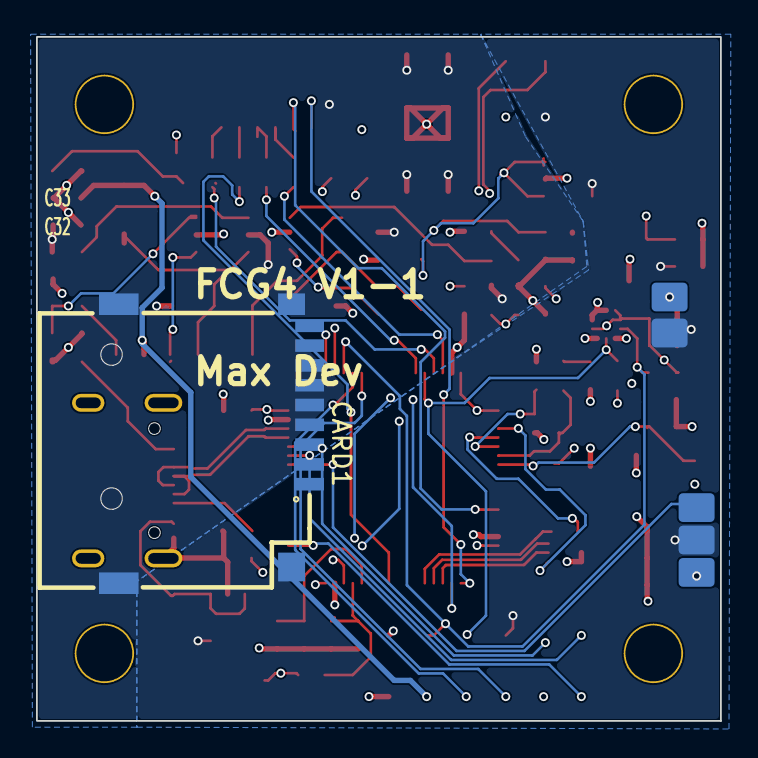
[picture p28: board fcg4.kicad_pcb from below]

Board: 4 copper layers, 38.0 x 38.0 mm, 100 parts (6 on the bottom side), 59 nets.
