maks7d/fcg4/(commit log)

2026-02-12 add first few components
    [1N5819HW-7-F.stp, AP2112K-1_8TRG1_DIO.step, Goertek SPL06-001.stp, MP9943AGQ-Z.stp, fcg4.kicad_sch, power.kicad_sch, sensor.kicad_sch]
2026-02-12 first components on schematic and few wiring
    [1N5819HW-7-F.stp, 2171750001.step, AP2112K-1_8TRG1_DIO.step, Goertek SPL06-001.stp, ICM-42688-P.step, MP9943AGQ-Z.stp, SM04B-SRSS-TB.STEP, connectors.kicad_sch]
2026-02-12 Remove lock file for mcu schematic to prevent conflicts during editing
    [fcg4.kicad_sch, mcu.kicad_sch, sensor.kicad_sch]
2026-02-13 Refactor sensor.kicad_sch: Adjust component positions and update property attributes for ICM-42688-P
    [ABM3C-25.000MHZ-D4Y-T.STEP, mcu.kicad_sch, power.kicad_sch, sensor.kicad_sch]
2026-02-13 Refactor code structure for improved readability and maintainability
    [USB4105-GF-A-120.step, mcu.kicad_sch]
2026-02-14 add sensors schematic
    [BLM18RK601SN1D.step, CX2016DB25000D0GPSC1.stp, mcu.kicad_sch, sensor.kicad_sch]
2026-02-14 finished buck schematic and designed solder pads footprints
    [connectors.kicad_sch, power.kicad_sch]
2026-02-15 add wiring to soldering pads for uart, dji, and esc
    [ECS-240-6-37B-7KM-TR.step, SM08B-SRSS-TB.step, connectors.kicad_sch, mcu.kicad_sch, power.kicad_sch]
2026-02-15 - Removed SBUS receiver support in uart1 and added esc telemetry in uart2 - Added a new Mounting Hole symbol with properties and graphical representation in the schematic (fcg4.kicad_sch). (MountingH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
    [connectors.kicad_sch, fcg4.kicad_pcb, fcg4.kicad_sch, mcu.kicad_sch]
2026-02-15 - affected footprints for components - started placing components
    [connectors.kicad_sch, fcg4.kicad_pcb, power.kicad_sch, sensor.kicad_sch]
2026-02-16 Placed every components on one face only
    [fcg4.kicad_pcb, mcu.kicad_sch, power.kicad_sch, sensor.kicad_sch]
2026-02-17 Started routing
    [fcg4.kicad_pcb]
2026-02-18 removed schottky diodes to use ideal diodes smaller
    [MAX40200ANS_T.step, fcg4.kicad_pcb, power.kicad_sch]
2026-02-18 add 100ohm for pwm and some routing
    [EXB-28V101JX.STEP, connectors.kicad_sch, fcg4.kicad_pcb, power.kicad_sch]
2026-02-18 add additional wire connections and update MOTOR labels in schematic
    [connectors.kicad_sch]
2026-02-20 Update board settings and design rules in KiCad project files
    - Changed active layer from 0 to 2 and disabled auto track width in fcg4.kicad_prl.
    - Adjusted column widths for better layout in fcg4.kicad_prl.
    - Increased silk text size and thickness for improved visibility in fcg4.kicad_pro.
    - Changed track and via dangling rules from warning to error for stricter design checks in fcg4.kicad_pro.
    - Updated minimum hole-to-hole clearance and via annular width for enhanced manufacturability in fcg4.kicad_pro.
    [fcg4.kicad_pcb]
2026-02-21 Update footprint references and component values in schematic files
    - Changed footprint property for a component in mcu.kicad_sch from "Package_DFN_QFN:QFN-48-1EP_7x7mm_P0.5mm_EP5.6x5.6mm" to "fcg4_fp:QFN-48-1EP_7x7mm_P0.5mm_EP5.6x5.6mm".
    - Updated value property for a component in mcu.kicad_sch from "SolderJumper_2_Open" to "BOOT".
    - Changed value property for another component in mcu.kicad_sch from "SolderJumper_2_Open" to "RESET".
    - Modified footprint property for a component in sensor.kicad_sch from "ProLib_pcs_2026-02-12:SENSOR-SMD_SPL06-001" to "fcg4_fp:SENSOR-SMD_SPL06-001".
    [fcg4.kicad_pcb, mcu.kicad_sch, sensor.kicad_sch]
2026-02-21 update routing and pcb cuts edge
    [connectors.kicad_sch, fcg4.kicad_pcb]
2026-02-21 Add new Gerber job file for fcg4 project with complete specifications and material stackup
    [connectors.kicad_sch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]
2026-02-21 Update KiCad project files and component specifications
    - Modified visible layers in fcg4.kicad_prl to adjust layer visibility settings.
    - Increased via diameter and drill size in fcg4.kicad_pro for improved connectivity.
    - Adjusted soldering pad dimensions in soldering_pad.kicad_mod for better fit.
    - Updated fp-info-cache with new identifier for BatteryClip_Keystone_54_D16-19mm.
    [fcg4.kicad_pcb]
2026-02-22 Update component properties in schematics with manufacturer details and datasheets
    - Added manufacturer name, part number, and LCSC part name for various components in mcu.kicad_sch, power.kicad_sch, and sensor.kicad_sch.
    - Updated datasheet links for components to point to the correct URLs.
    - Ensured all new properties are hidden in the schematic view.
    [connectors.kicad_sch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]
2026-02-23 update edges
    [fcg4.kicad_pcb]
2026-02-24 Almost completed! Update component properties in sensor schematic
    - Added datasheets, LCSC part names, manufacturer names, and manufacturer part numbers for various components in the sensor.kicad_sch file.
    - Updated the datasheet links for components to point to the correct URLs.
    [connectors.kicad_sch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]
2026-02-25 PCB v1 ready for manufacturing all the CAM files are available in CAM folder
    [connectors.kicad_sch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]
2026-02-25 Add Availability and Price properties to multiple components in schematic
    [MAX40203AUK+T.stp, connectors.kicad_sch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]
2026-02-27 update buck regulator to a more recent one
    [DFLS160-7.stp, MP2456GJ-Z.stp, fcg4.kicad_pcb, power.kicad_sch]
2026-02-28 finished re routing with new buck regulators
    [fcg4.kicad_pcb]
2026-03-20 switch stm323g473ceu6 to stm32g473cet6 for easier soldering package
    [STM32G473CET6.stp, STM32G473RCT6.stp, mcu.kicad_sch]
2026-03-23 reorganized everything and switched to 0603 as a minimum size
    [connectors.kicad_sch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]
2026-04-01 update routing
    [fcg4.kicad_pcb, mcu.kicad_sch]
2026-04-10 update silkscreen
    [fcg4-B_Cu.gbr, fcg4-B_Mask.gbr, fcg4-B_Paste.gbr, fcg4-B_Silkscreen.gbr, fcg4-Edge_Cuts.gbr, fcg4-F_Cu.gbr, fcg4-F_Mask.gbr, fcg4-F_Paste.gbr]
2026-04-11 changed barometer to BMP580 and completed BOM
    [connectors.kicad_sch, fcg4-bom-jlcpcb.csv, fcg4-top-clean.csv, fcg4-top-jlcpcb.csv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]
2026-04-12 switch IMU to BMI270
    [BMI270.stp, connectors.kicad_sch, fcg4-bom-jlcpcb.csv, fcg4-top-jlcpcb.csv, fcg4.kicad_pcb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]
2026-05-31 add microsd card connector
    [.step, Stencil_jig_template.stl, connectors.kicad_sch, fcg4.kicad_pcb, fcg4.kicad_sch, mcu.kicad_sch, power.kicad_sch, sensor.kicad_sch]
